natemueller/video-card/doc/framebuffer.png

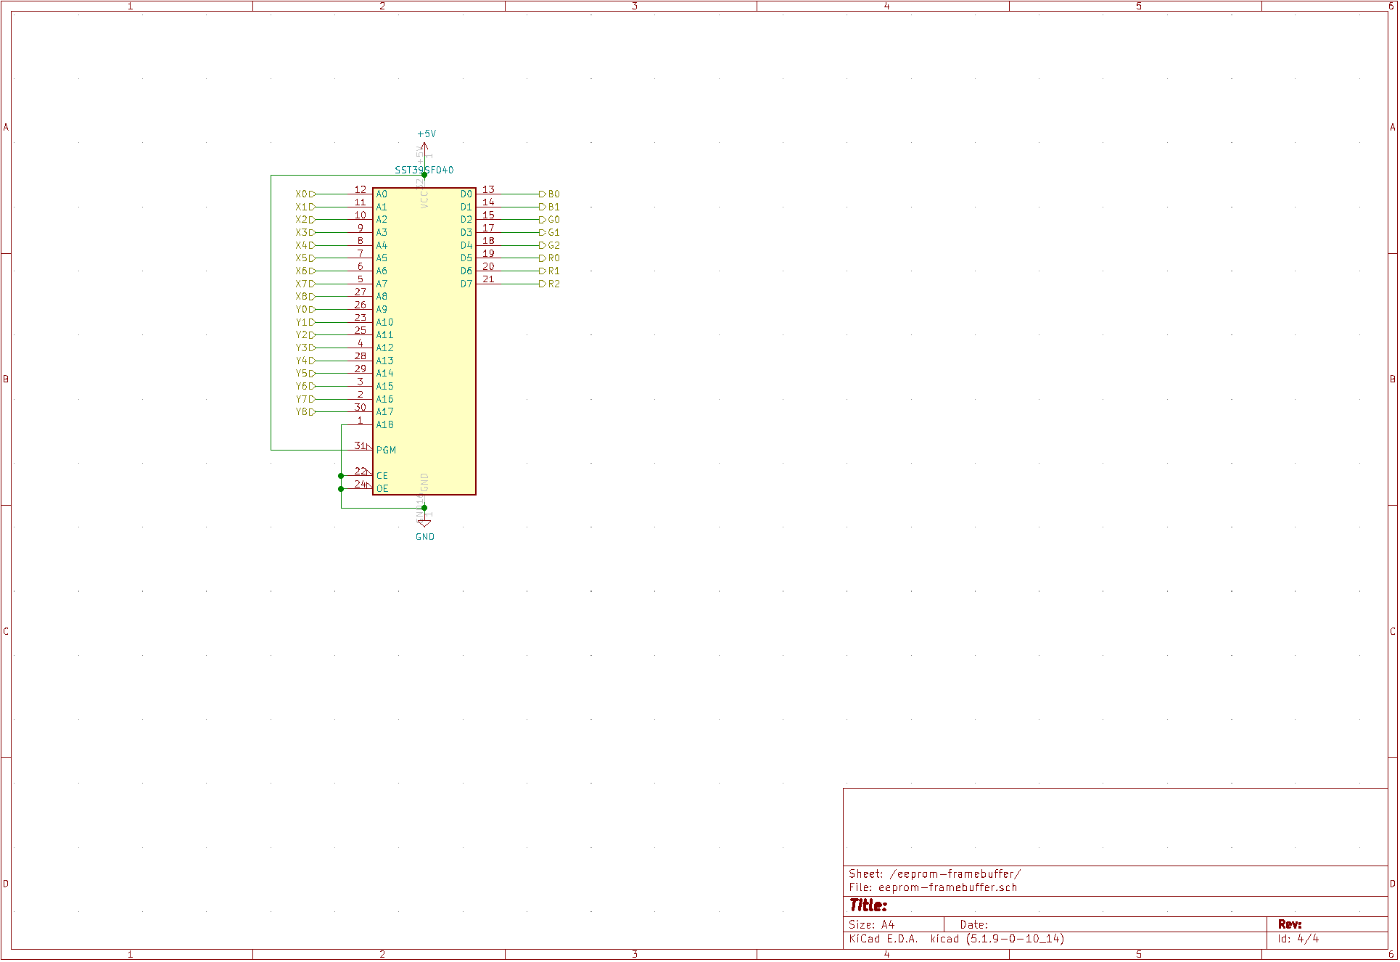
doc/framebuffer.png
