natemueller/video-card/doc/hsync.png

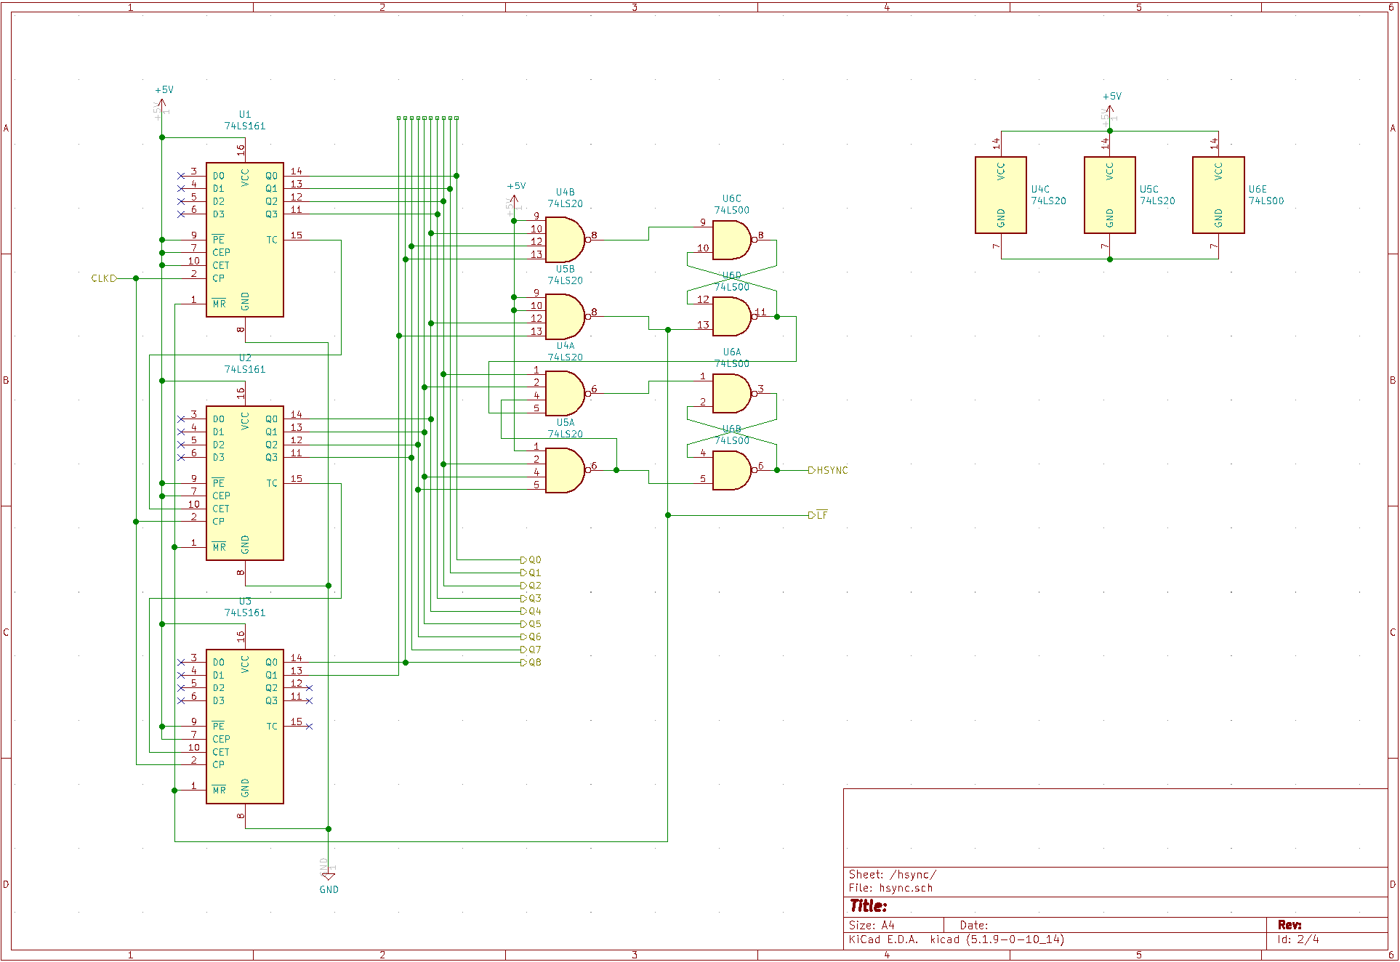
doc/hsync.png
