natemueller/video-card/doc/top-level.png

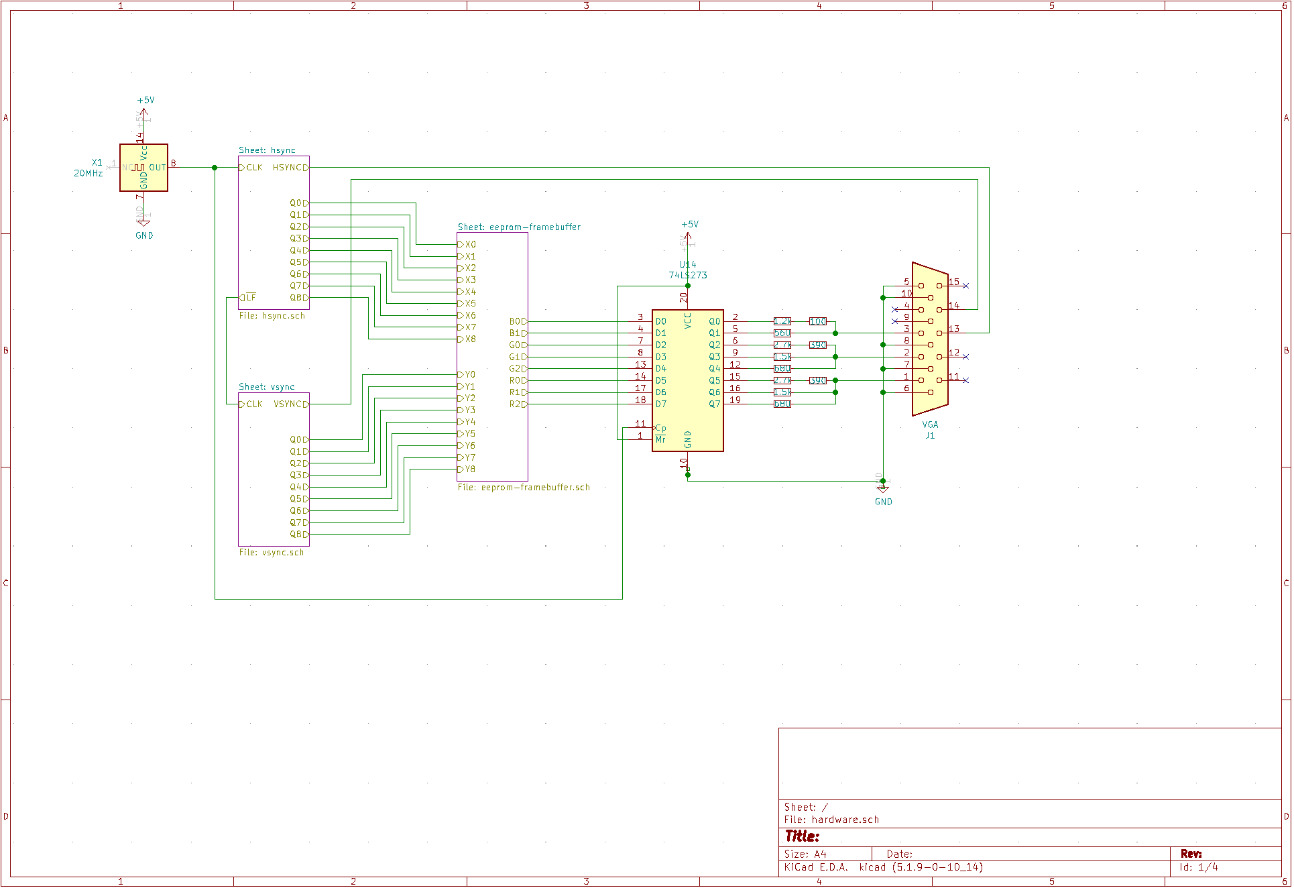
doc/top-level.png
