natemueller/video-card/doc/vsync.png

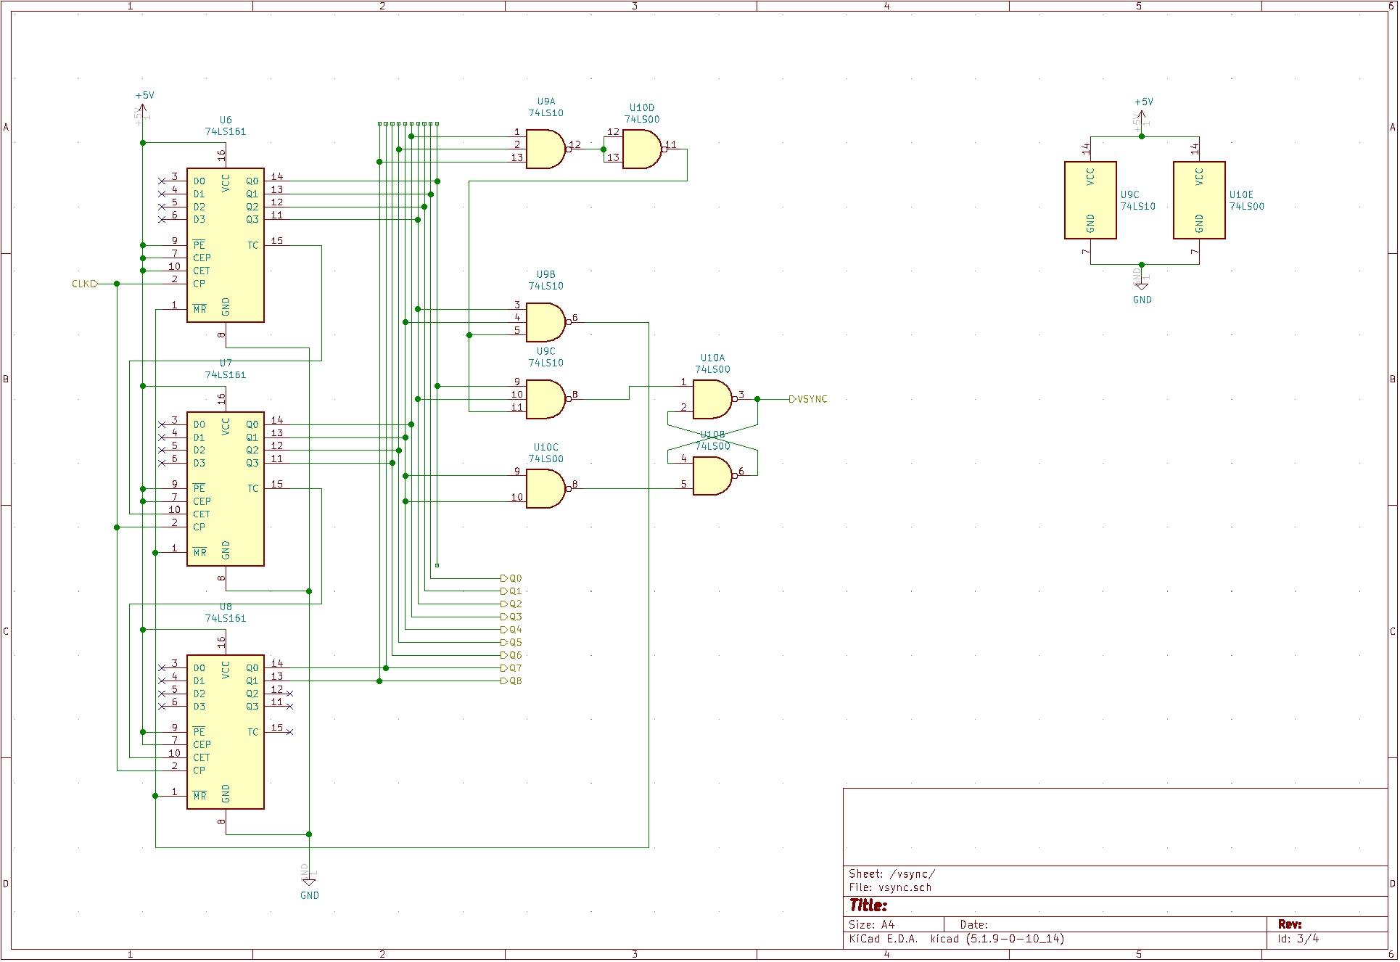
doc/vsync.png
