natemueller/video-card/(commit log)

2021-01-16 400x300 mode
    Bump up to a 20MHz oscillator and larger ROM. Latch data from the ROM
    into a set of flip-flops to work around the long setup time on the
    EEPROM.
    [framebuffer.sch, hardware.kicad_pcb, hardware.sch, hsync.sch, vsync.sch]
2021-01-17 Clean up EEPROM framebuffer design
    Drop the extra pins
    [eeprom-framebuffer.sch, hardware.sch]
2021-01-23 Drop another chip by stretching the vsync pulse
    Works fine on my test LCDs. No idea what would happen with a CRT.
    [hardware.sch, hsync.sch, vsync.sch]
2021-01-24 Add png output of schematics
